youefkh05/ArduScope/README.md

# ArduScope
The purpose of this project is to address the empowerment of young people from lower-income backgrounds by providing them with affordable electronics kits that inspire future Electrical Engineers and pave the way for their success.
