youefkh05/ArduScope/Video/عربي.docx

أول حاجة مقدمة كله هيعملها

I'm (your name)

and We're Arduscope Team!

Khaled: @Khaled Sarhan duino

شرح فكرة المشروع وانا هحط في الخلفية كل جهاز وهو بيشتغل وقول كل جهاز براحة يعني قول فولت بعدها اسكت ثانية والجهاز اللي بعده

Voltmeter... and Ammetre... and Ohmeter.... with Signal generator.... and Oscilloscope

أنا هتكلم عن الهارد وير

Ameer @Ameer Louly duino :

The programming process

هتقوله ازاي عملت ال list باللوجو علي ال oled (طريقة ال pixel art اللي عملتها ده)

وبعدها أنا هقوله المشكلة اللي قابلتنا كانت الميموري وحلتها عن طريق ال EEROM

What we learn:

أنا ال EEROM

@Khaled Sarhan duino

خالد IC Design

@Ameer Louly duino

ال oled logos

Khaled @Khaled Sarhan duino :

هيخش تاني للختام

Future Work:

add more ranges with better accuracy

and for the oscilloscope to read higher frequencies
