youefkh05/ArduScope/Report/Bill/Nikhel.pdf

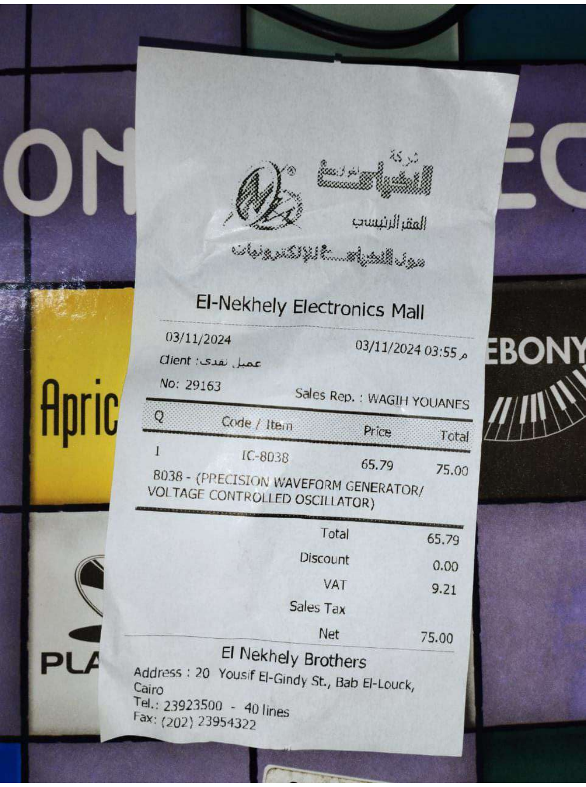
[picture p15: page 1]
