youefkh05/ArduScope/Report/Bill/RAM.pdf

CamScanner (https://v3.camscanner.com/user/download)

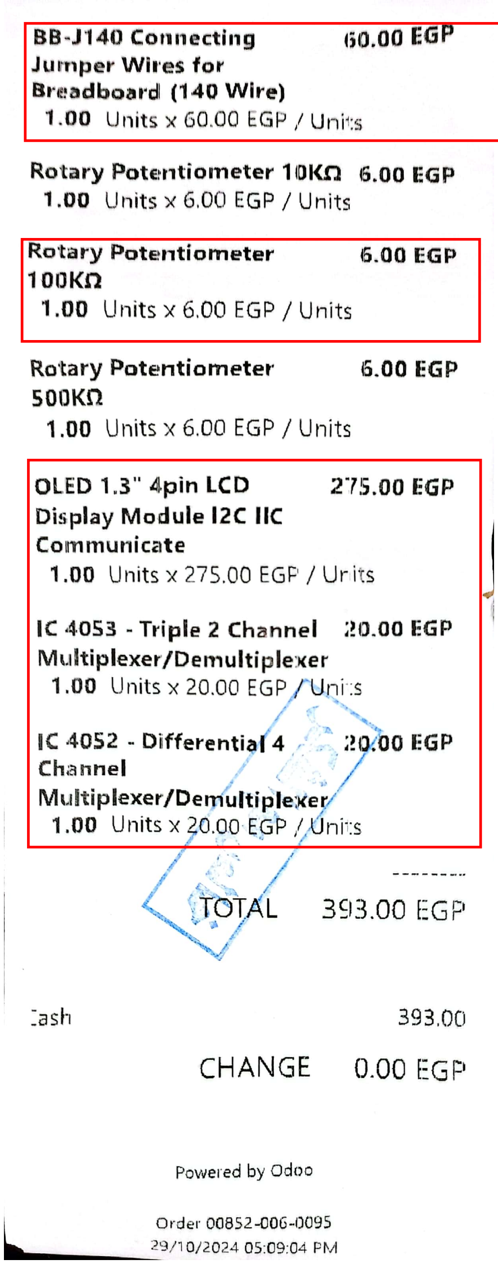
[picture p16: figure]
