youefkh05/ArduScope/Report/IEEEDuino 2024 Expenses Report.xlsx

Team Name | Yousef Khaled Omar Mahmoud
IEEE Section | Egypt
Currency used in the Expense Report | LE (Egypt) to USD
conversion rate | 50 LE/$
Expenses list
Item | Amount (LE) | Amount (USA) | Description and Comments
Arduino Nano | 275 | 5.5 | Arduino Nano 328 With CH340 Chip - Clone
USB Cable | 85 | 1.7 | USB Micro Cable Shielded 1.4m
Breadboard | 180 | 3.6 | BB-01 Breadboard 830 Tie Point
Push Button | 7 | 0.14 | The bigger size 6x6x9 mm
OLED | 275 | 5.5 | OLED 1.3" 4pin LCD Display Module I2C IIC Communicate
LM741 | 64 | 1.28 | UA741CP - Original
IC 4052 | 20 | 0.4 | IC 4052 - Differential 4 Channel Multiplexer/Demultiplexer
IC 4053 | 20 | 0.4 | IC 4053 - Triple 2 Channel Multiplexer/Demultiplexer
Pot 100k | 6 | 0.12 | 100k Ohm Potintiometre
Resistors | 5 | 0.1 | Ohm Resistor
Capacitor | 4.5 | 0.09 | Farad Capacitor
1N4148 | 1.5 | 0.03 | Small Signal Fast Switching Diodes
1N4007 | 2.5 | 0.05 | 1N4007 General Purpose Silicon Diode 1A - 1000V
TOTAL | 945.5 | 18.91
