youefkh05/ArduScope/Report/ArduScope Component.xlsx

Sheet: Sheet1
Comp Name | Description | Price in L.E | $ | Num | Total | Total $
Arduino Nano | Arduino Nano 328 With CH340 Chip - Clone | 275 | 5.5 | 1 | 275 | 5.5 | Total in L.E | Total in $
USB Cable | USB Micro Cable Shielded 1.4m | 85 | 1.7 | 1 | 85 | 1.7 | 945.5 | 18.91
Breadboard | BB-01 Breadboard 830 Tie Point | 60 | 1.2 | 3 | 180 | 3.6
Push Button | The bigger size 6x6x9 mm | 1 | 0.02 | 7 | 7 | 0.14
OLED | OLED 1.3" 4pin LCD Display Module I2C IIC Communicate | 275 | 5.5 | 1 | 275 | 5.5
LM741 | UA741CP - Original | 8 | 0.16 | 8 | 64 | 1.28
IC 4052 | IC 4052 - Differential 4 Channel Multiplexer/Demultiplexer | 20 | 0.4 | 1 | 20 | 0.4
IC 4053 | IC 4053 - Triple 2 Channel Multiplexer/Demultiplexer | 20 | 0.4 | 1 | 20 | 0.4
Pot 100k | 100k Ohm Potintiometre | 6 | 0.12 | 1 | 6 | 0.12
Resistors | Ohm Resistor | 0.2 | 0.004 | 25 | 5 | 0.1
Capacitor | Farad Capacitor | 1.5 | 0.03 | 3 | 4.5 | 0.09
1N4148 | Small Signal Fast Switching Diodes | 1.5 | 0.03 | 1 | 1.5 | 0.03
1N4007 | 1N4007 General Purpose Silicon Diode 1A - 1000V | 0.5 | 0.01 | 5 | 2.5 | 0.05

Sheet: Resistor
R | 1 | 2 | 3 | Tolerance | Shape
10
1k
1
100
12
100k
22
2.2k
1.5
12k
10
20k
15k
10k
220k
22k
2
1M
68K
24
180k
560k

Sheet: Tahrir
Comp Name | Description | Price in L.E | $ | Num | Total | Total $ | Availbale
Arduino Nano | Arduino Nano 328 With CH340 Chip - Clone | 275 | 5.5 | 1 | 275 | 5.5 | NO | Total in L.E | Total in $
USB Cable | USB Micro Cable Shielded 1.4m | 85 | 1.7 | 1 | 85 | 1.7 | NO | 1138 | 22.76
Breadboard | BB-01 Breadboard 830 Tie Point | 40 | 0.8 | 3 | 120 | 2.4 | NO
Adapter 5Vdc | Wall Power Adapter 5Vdc 2A - Dual Size Jack Output | 75 | 1.5 | 1 | 75 | 1.5 | NO
Male-Male | PH61 - 20cm Male to Male 40 Jumper Wires Set | 35 | 0.7 | 1 | 35 | 0.7 | NO
Male-Female | PH60 - 20cm Male to Female 40 Jumper Wires Set | 35 | 0.7 | 1 | 35 | 0.7 | NO
Push Button | The bigger size 6x6x9 mm | 1 | 0.02 | 8 | 8 | 0.16 | NO
OLED | OLED 1.3" 4pin LCD Display Module I2C IIC Communicate | 275 | 5.5 | 1 | 275 | 5.5 | NO
LM741 | UA741CP - Original | 10 | 0.2 | 8 | 80 | 1.6 | NO
IC 4052 | IC 4052 - Differential 4 Channel Multiplexer/Demultiplexer | 20 | 0.4 | 1 | 20 | 0.4 | NO
IC 4053 | IC 4053 - Triple 2 Channel Multiplexer/Demultiplexer | 20 | 0.4 | 1 | 20 | 0.4 | NO
ICL7660 | CMOS Voltage Converter | 20 | 0.4 | 1 | 20 | 0.4 | NO
Crocodile Clip | Crocodile Clip for 4mm Plug | 10 | 0.2 | 4 | 40 | 0.8 | NO
Slider Switch | Slide Switch 3-Pin that's big size | 5 | 0.1 | 2 | 10 | 0.2 | NO
Pot 500k | 500k Ohm Potintiometre | 1 | 0.02 | 2 | 2 | 0.04 | NO
Pot 100k | 100k Ohm Potintiometre | 1 | 0.02 | 2 | 2 | 0.04 | NO
Pot 10k | 10k Ohm Potintiometre | 1 | 0.02 | 2 | 2 | 0.04 | NO
R100k | 100k Ohm Resistor | 0.25 | 0.005 | 6 | 1.5 | 0.03 | NO
R5.1k | 5.1k Ohm Resistor | 0.25 | 0.005 | 2 | 0.5 | 0.01 | NO
R1k | 1k Ohm Resistor | 0.25 | 0.005 | 8 | 2 | 0.04 | NO
R2 | 2 Ohm Resistor | 0.25 | 0.005 | 2 | 0.5 | 0.01 | NO
R180k | 180k Ohm Resistor | 0.25 | 0.005 | 2 | 0.5 | 0.01 | NO
R12k | 12k Ohm Resistor | 0.25 | 0.005 | 2 | 0.5 | 0.01 | NO
R10k | 10k Ohm Resistor | 0.25 | 0.005 | 8 | 2 | 0.04 | NO
R200k | 200k Ohm Resistor | 0.25 | 0.005 | 2 | 0.5 | 0.01 | NO
R500k | 500k Ohm Resistor | 0.25 | 0.005 | 2 | 0.5 | 0.01 | NO
R390k | 390k Ohm Resistor | 0.25 | 0.005 | 2 | 0.5 | 0.01 | NO
R20k | 20k Ohm Resistor | 0.25 | 0.005 | 2 | 0.5 | 0.01 | NO
R3k | 3k Ohm Resistor | 0.25 | 0.005 | 2 | 0.5 | 0.01 | NO
R100 | 100 Ohm Resistor | 0.25 | 0.005 | 2 | 0.5 | 0.01 | NO
R1M | 1M Ohm Resistor | 0.25 | 0.005 | 2 | 0.5 | 0.01 | NO
C1n | 1n Farad Capacitor | 0.25 | 0.005 | 2 | 0.5 | 0.01 | NO
C100n | 100n Farad Capacitor | 0.25 | 0.005 | 4 | 1 | 0.02 | NO
C10u | 10u Farad Capacitor | 0.25 | 0.005 | 4 | 1 | 0.02 | NO
C100u | 100u Farad Capacitor | 0.25 | 0.005 | 2 | 0.5 | 0.01 | NO
1N4148 | Small Signal Fast Switching Diodes | 1 | 0.02 | 2 | 2 | 0.04 | NO
1N4732A | 1N4732 4.7V 1W Zener Diode | 7 | 0.14 | 2 | 14 | 0.28 | NO
1N4007 | 1N4007 General Purpose Silicon Diode 1A - 1000V | 0.5 | 0.01 | 8 | 4 | 0.08 | NO
 |  |  | 0 |  | 0 | 0 | NO
 |  |  | 0 |  | 0 | 0 | NO
 |  |  | 0 |  | 0 | 0 | NO
 |  |  | 0 |  | 0 | 0 | NO
 |  |  |  |  | 0 | 0 | NO
 |  |  |  |  | 0 | 0 | NO
 |  |  |  |  | 0 | 0 | NO
 |  |  |  |  | 0 |  | NO
 |  |  |  |  |  |  | NO
 |  |  |  |  |  |  | NO
 |  |  |  |  |  |  | NO
 |  |  |  |  |  |  | NO
 |  |  |  |  |  |  | NO
 |  |  |  |  |  |  | NO
 |  |  |  |  |  |  | NO
 |  |  |  |  |  |  | NO
 |  |  |  |  |  |  | NO
 |  |  |  |  |  |  | NO
 |  |  |  |  |  |  | NO
 |  |  |  |  |  |  | NO
 |  |  |  |  |  |  | NO
 |  |  |  |  |  |  | NO
 |  |  |  |  |  |  | NO
 |  |  |  |  |  |  | NO
 |  |  |  |  |  |  | NO
 |  |  |  |  |  |  | NO
 |  |  |  |  |  |  | NO
 |  |  |  |  |  |  | NO
 |  |  |  |  |  |  | NO
 |  |  |  |  |  |  | NO
 |  |  |  |  |  |  | NO
 |  |  |  |  |  |  | NO
 |  |  |  |  |  |  | NO
 |  |  |  |  |  |  | NO
 |  |  |  |  |  |  | NO
 |  |  |  |  |  |  | NO
 |  |  |  |  |  |  | NO
 |  |  |  |  |  |  | NO
 |  |  |  |  |  |  | NO
 |  |  |  |  |  |  | NO
 |  |  |  |  |  |  | NO
 |  |  |  |  |  |  | NO
 |  |  |  |  |  |  | NO
 |  |  |  |  |  |  | NO
 |  |  |  |  |  |  | NO
 |  |  |  |  |  |  | NO
 |  |  |  |  |  |  | NO
 |  |  |  |  |  |  | NO
 |  |  |  |  |  |  | NO
 |  |  |  |  |  |  | NO
 |  |  |  |  |  |  | NO
 |  |  |  |  |  |  | NO
 |  |  |  |  |  |  | NO
 |  |  |  |  |  |  | NO
 |  |  |  |  |  |  | NO
 |  |  |  |  |  |  | NO
 |  |  |  |  |  |  | NO
 |  |  |  |  |  |  | NO
 |  |  |  |  |  |  | NO
 |  |  |  |  |  |  | NO
 |  |  |  |  |  |  | NO
 |  |  |  |  |  |  | NO
 |  |  |  |  |  |  | NO
 |  |  |  |  |  |  | NO
 |  |  |  |  |  |  | NO
 |  |  |  |  |  |  | NO
 |  |  |  |  |  |  | NO
 |  |  |  |  |  |  | NO
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
 |  |  |  |  |  |  | NO
 |  |  |  |  |  |  | NO
 |  |  |  |  |  |  | NO
 |  |  |  |  |  |  | NO
 |  |  |  |  |  |  | NO
 |  |  |  |  |  |  | NO
 |  |  |  |  |  |  | NO
 |  |  |  |  |  |  | NO
 |  |  |  |  |  |  | NO
 |  |  |  |  |  |  | NO
 |  |  |  |  |  |  | NO
 |  |  |  |  |  |  | NO
