youefkh05/ArduScope/Simulation/Signal Gen/FUNCTION GENERATOR ICL8038/DSO OP.pdf

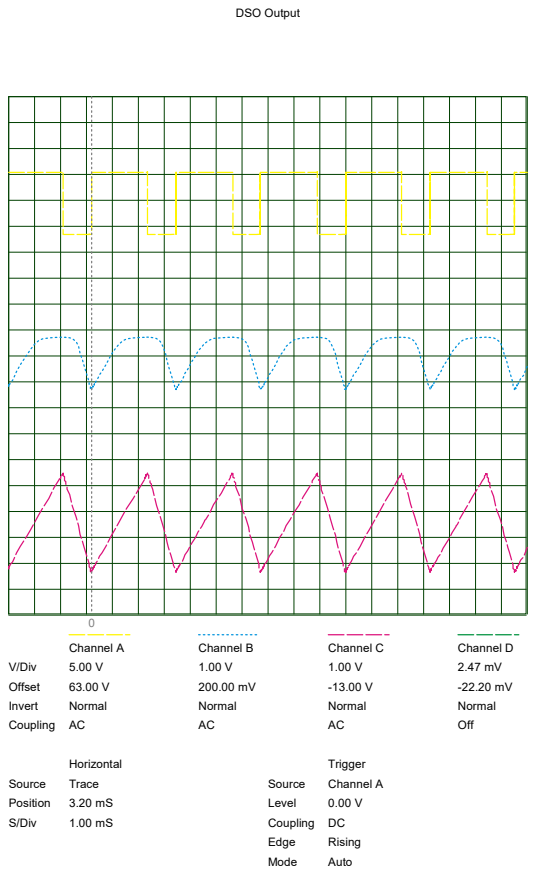
[picture p17: page 1]
DSO Output; V/Div Offset Invert Coupling; Channel A 5.00 V 63.00 V Normal AC; Channel B 1.00 V 200.00 mV Normal AC; Channel C 1.00 V -13.00 V Normal AC; Channel D 2.47 mV -22.20 mV Normal Off; Horizontal; Source Position S/Div; Trace 3.20 mS 1.00 mS; Trigger; Source Level Coupling Edge Mode; Channel A 0.00 V DC Rising Auto
