youefkh05/ArduScope/(list of files, drawings)

Other design files:
Simulation/Ameter_test.pdsprj
Simulation/Analog_Mux_Test.pdsprj
Simulation/App Test.pdsprj
Simulation/Ardu Ocsi MM.pdsprj
Simulation/Ocsilloscpe Test.pdsprj
Simulation/OHM_test .pdsprj
Simulation/Project Backups/Ameter_test [20241016, 21-12-04].pdsprj
Simulation/Project Backups/Ameter_test [20241016, 22-32-01].pdsprj
Simulation/Project Backups/Ameter_test [20241022, 14-19-21].pdsprj
Simulation/Project Backups/Ameter_test [20241022, 14-43-55].pdsprj
Simulation/Project Backups/Ameter_test [20241028, 09-45-11].pdsprj
Simulation/Project Backups/Analog_Mux_Test [20241016, 12-39-41].pdsprj
Simulation/Project Backups/App Test [20241028, 10-33-46].pdsprj
Simulation/Project Backups/App Test [20241102, 14-48-27].pdsprj
Simulation/Project Backups/App Test [20241103, 12-03-20].pdsprj
Simulation/Project Backups/App Test [20241104, 09-50-23].pdsprj
Simulation/Project Backups/App Test [20241104, 09-53-16].pdsprj
Simulation/Project Backups/App Test [20241108, 10-38-39].pdsprj
Simulation/Project Backups/Ardu Ocsi MM - Copy [20241015, 12-36-51].pdsprj
Simulation/Project Backups/Ardu Ocsi MM - Copy [20241015, 14-16-43].pdsprj
Simulation/Project Backups/Ardu Ocsi MM [20241022, 14-19-22].pdsprj
Simulation/Project Backups/Ardu Ocsi MM [20241022, 14-43-53].pdsprj
Simulation/Project Backups/Ardu Ocsi MM [20241022, 14-46-21].pdsprj
Simulation/Project Backups/Ardu Ocsi MM [20241022, 21-13-32].pdsprj
Simulation/Project Backups/Ardu Ocsi MM [20241023, 12-56-41].pdsprj
Simulation/Project Backups/Ardu Ocsi MM [20241023, 13-01-33].pdsprj
Simulation/Project Backups/Ardu Ocsi MM [20241023, 13-05-48].pdsprj
Simulation/Project Backups/Ardu Ocsi MM [20241030, 12-55-29].pdsprj
Simulation/Project Backups/Ardu Ocsi MM [20241030, 17-13-44].pdsprj
Simulation/Project Backups/Ardu Ocsi MM [20241109, 20-14-22].pdsprj
Simulation/Project Backups/MM_Test [20241015, 19-44-46].pdsprj
Simulation/Project Backups/Ocsilloscpe Test [20241026, 14-43-50].pdsprj
Simulation/Project Backups/Ocsilloscpe Test [20241026, 14-43-51].pdsprj
Simulation/Project Backups/Ocsilloscpe Test [20241026, 23-51-34].pdsprj
Simulation/Project Backups/Ocsilloscpe Test [20241027, 22-46-38].pdsprj
Simulation/Project Backups/Ocsilloscpe Test [20241028, 10-12-29].pdsprj
Simulation/Project Backups/Ocsilloscpe Test [20241105, 21-48-28].pdsprj
Simulation/Project Backups/Ocsilloscpe Test [20241106, 21-08-37].pdsprj
Simulation/Project Backups/Ocsilloscpe Test [20241106, 21-50-35].pdsprj
Simulation/Project Backups/Ocsilloscpe Test [20241107, 15-33-00].pdsprj
Simulation/Project Backups/Ocsilloscpe Test [20241108, 10-38-46].pdsprj
Simulation/Project Backups/OHM_test [20241022, 14-46-15].pdsprj
Simulation/Project Backups/OHM_test [20241030, 11-41-39].pdsprj
Simulation/Project Backups/Signal_Gen_Test [20241109, 16-52-29].pdsprj
Simulation/Project Backups/VOLT_test [20241022, 14-10-31].pdsprj
Simulation/Project Backups/VOLT_test [20241022, 14-17-11].pdsprj
Simulation/Project Backups/VOLT_test [20241022, 14-43-56].pdsprj
Simulation/Project Backups/VOLT_test [20241028, 09-45-13].pdsprj
Simulation/Project Backups/VOLT_test [20241030, 12-55-27].pdsprj
Simulation/Project Backups/VOLT_test [20241030, 13-59-22].pdsprj
Simulation/Project Backups/VOLT_test [20241030, 14-01-12].pdsprj
Simulation/Project Backups/VOLT_test [20241030, 15-58-10].pdsprj
Simulation/Signal Gen/FUNCTION GENERATOR ICL8038/Project Backups/function generoter icl8038 WORKING [20241106, 22-13-27].pdsprj
Simulation/Signal Gen/FUNCTION GENERATOR ICL8038/Project Backups/function generoter icl8038 WORKING [20241107, 15-33-04].pdsprj
Simulation/Signal Gen/Signal_Gen.ms14
Simulation/Signal_Gen_test.pdsprj
Simulation/VOLT_test.pdsprj
