youefkh05/ArduScope/(commit log)

2024-10-11 Added the simulation
    It contains:
    1.Arduino Block
    2.Power Block
    3.Ohmetre Block
    4.Voltmetre Block
    5.Ametre Block
    6.Dc Bias Block
    7.Dc out Block
    8.Ac Bias Block
    9.Selector Block
    10.Signal Generator Block
    [Ardu Ocsi MM [20240501, 12-41-49].pdsprj, Ardu Ocsi MM [20240519, 02-29-17].pdsprj, Ardu Ocsi MM [20240519, 02-43-08].pdsprj, Ardu Ocsi MM.pdsprj]
2024-10-11 Organized the res
    Made a Report and Simulation folder
    [Ardu Ocsi MM [20240501, 12-41-49].pdsprj, Ardu Ocsi MM [20240519, 02-29-17].pdsprj, Ardu Ocsi MM [20240519, 02-43-08].pdsprj, Ardu Ocsi MM.pdsprj]
2024-10-11 Added the Arduino library
    It has the arduino boatloader
    [Ardu Ocsi MM [20241011, 20-53-42].pdsprj, Ardu Ocsi MM [20241011, 21-50-26].pdsprj, Ardu Ocsi MM.pdsprj, MM Full [20240418, 10-46-46].pdsprj, MM Full [20240418, 11-04-10].pdsprj, MM Full [20240418, 11-49-43].pdsprj, MM Full.pdsprj]
2024-10-13 Added FreeRTOS
    Added the FreeRTOS library for Arduino
    Arduino_FreeRTOS.h
    [Ardu Ocsi MM [20241011, 22-08-27].pdsprj, Ardu Ocsi MM [20241013, 07-18-47].pdsprj, Ardu Ocsi MM.pdsprj]
2024-10-13 Added OLED
    its 128*64 I2C OLED
    [Ardu Ocsi MM [20241013, 11-17-06].pdsprj, Ardu Ocsi MM.pdsprj]
2024-10-13 Made the simulation layout
    It's more Organized and contains these blocks:
    1.GND
    2.NEGATIVE_REGULATOR1
    3.POSITIVE_REGULATOR1
    4.MC_VCC
    5.DC_POWER
    6.AC_OUT
    7.+2.5V_DC_BIAS
    8.Voltage Circuit
    9.Ammeter
    10.ohmetre
    11.Selector Block
    12.Signal generator
    13.Arduino Block
    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
    [Ardu Ocsi MM [20241013, 12-28-38].pdsprj, Ardu Ocsi MM [20241013, 12-41-34].pdsprj, Ardu Ocsi MM.pdsprj]
2024-10-14 Made DC only block
    It's much smaller than before
    [Ardu Ocsi MM [20240501, 12-41-49].pdsprj, Ardu Ocsi MM [20240519, 02-29-17].pdsprj, Ardu Ocsi MM [20241014, 17-16-18].pdsprj, Ardu Ocsi MM [20241014, 17-16-36].pdsprj, Ardu Ocsi MM.pdsprj]
2024-10-15 Added the Multi_Metre header
    Function Prototypes:
    Read_Volt
    Read_Amp
    Display_Ohm
    Select_Mux
    Ask_To_Return
    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
    [Ardu Ocsi MM - Copy [20241015, 12-36-51].pdsprj, Ardu Ocsi MM - Copy [20241015, 14-16-43].pdsprj, Ardu Ocsi MM - Copy.pdsprj, Ardu Ocsi MM [20240519, 02-43-08].pdsprj, Ardu Ocsi MM [20241011, 20-53-42].pdsprj, Ardu Ocsi MM [20241015, 12-33-21].pdsprj, Ardu Ocsi MM [20241015, 14-16-40].pdsprj, Ardu Ocsi MM.pdsprj]
2024-10-16 Added Read_Volt Function
    It converts the analog input into a volt value whether it's AC or DC
    [Ardu Ocsi MM [20241011, 21-50-26].pdsprj, Ardu Ocsi MM [20241015, 19-44-53].pdsprj, Ardu Ocsi MM.pdsprj, MM_Test [20241015, 19-44-46].pdsprj, MM_Test.pdsprj, VOLT ac_test.pdsprj]
2024-10-16 Added Read_Ohm Function
    It reads the Rin and converts it to Resistor value in Ohm
2024-10-16 Added the Select_Mux function
    It's used to select the devices with its ranges using the analog Mux
    [Ardu Ocsi MM [20241011, 22-08-27].pdsprj, Ardu Ocsi MM [20241016, 10-31-20].pdsprj, Ardu Ocsi MM.pdsprj]
2024-10-16 Edited the voltametre device
    It works better now
    [Analog_Mux_Test [20241016, 12-39-41].pdsprj, Analog_Mux_Test.pdsprj, Ardu Ocsi MM [20241013, 07-18-47].pdsprj, Ardu Ocsi MM [20241016, 15-17-09].pdsprj, Ardu Ocsi MM.pdsprj, VOLT ac_test [20241016, 15-17-08].pdsprj, VOLT ac_test.pdsprj]
2024-10-16 Finished the voltameter device
    It works properly
    [Ardu Ocsi MM [20241013, 11-17-06].pdsprj, Ardu Ocsi MM [20241013, 12-28-38].pdsprj, Ardu Ocsi MM [20241016, 17-54-56].pdsprj, Ardu Ocsi MM [20241016, 19-24-00].pdsprj, Ardu Ocsi MM.pdsprj, VOLT ac_test [20241016, 17-54-54].pdsprj, VOLT ac_test [20241016, 19-24-01].pdsprj, VOLT ac_test.pdsprj]
2024-10-16 Finished Ameter Device
    It works propely now
    [Ameter_test [20241016, 19-39-09].pdsprj, Ameter_test [20241016, 21-12-04].pdsprj, Ameter_test [20241016, 22-32-01].pdsprj, Ameter_test.pdsprj, Ardu Ocsi MM [20241013, 12-41-34].pdsprj, Ardu Ocsi MM [20241014, 17-16-18].pdsprj, Ardu Ocsi MM [20241014, 17-16-36].pdsprj, Ardu Ocsi MM [20241016, 20-52-56].pdsprj]
2024-10-16 Finished The MM
    It contains: Ammeter, Voltmeter, Ohmeter
    [Ardu Ocsi MM [20241015, 12-33-21].pdsprj, Ardu Ocsi MM [20241016, 23-35-11].pdsprj, Ardu Ocsi MM.pdsprj, OHM_test [20241016, 23-18-55].pdsprj, OHM_test .pdsprj]
2024-10-16 Finished the MM
    It works properly in real time
    [Ardu Ocsi MM [20241015, 14-16-40].pdsprj, Ardu Ocsi MM [20241015, 19-44-53].pdsprj, Ardu Ocsi MM [20241016, 23-46-57].pdsprj, Ardu Ocsi MM [20241017, 00-27-37].pdsprj, Ardu Ocsi MM.pdsprj, MM_Test.pdsprj, Signal_Gen [20241017, 00-29-08].pdsprj, Signal_Gen.pdsprj]
2024-10-22 Added Multi_Metre Enumes
    added devices, ranges and modes enums
2024-10-22 Modified the volt circuit simulation
    It now operators with 5,3.3 volt (using the arduino nano power)
    [Ameter_test [20241022, 14-19-21].pdsprj, Ameter_test.pdsprj, Ardu Ocsi MM [20241016, 10-31-20].pdsprj, Ardu Ocsi MM [20241022, 14-19-22].pdsprj, Ardu Ocsi MM.pdsprj, MM Full [20240418, 10-46-46].pdsprj, MM Full [20240418, 11-04-10].pdsprj, MM Full [20240418, 11-49-43].pdsprj]
2024-10-22 Modified the MM_Circuit
    Now it operates at 5, 3.3 Volt
    [Ameter_test [20241022, 14-43-55].pdsprj, Ameter_test.pdsprj, Ardu Ocsi MM [20241016, 15-17-09].pdsprj, Ardu Ocsi MM [20241016, 17-54-56].pdsprj, Ardu Ocsi MM [20241022, 14-43-53].pdsprj, Ardu Ocsi MM [20241022, 14-46-21].pdsprj, Ardu Ocsi MM.pdsprj, OHM_test [20241022, 14-46-15].pdsprj]
2024-10-22 Added the Signal Generator Circuit
    It contains Sin, Tri and square waves with 5-50k Hz
    [Ardu Ocsi MM [20241016, 19-24-00].pdsprj, Ardu Ocsi MM [20241022, 21-13-32].pdsprj, Ardu Ocsi MM.pdsprj, Signal_Gen [20241022, 21-13-40].pdsprj, Signal_Gen [20241022, 21-32-47].pdsprj, Signal_Gen.ms14, Signal_Gen.pdsprj, Signal_Gen_test - Copy [20241022, 19-22-46].pdsprj]
2024-10-23 Added the sig header file
    It's now MM_Sig that controlls the MM and sig devices
    [Signal_Gen [20241023, 11-00-20].pdsprj, Signal_Gen [20241023, 11-27-01].pdsprj, Signal_Gen.ms14, Signal_Gen.pdsprj]
2024-10-23 Signal generator header file finished
    It contains : Square, Triangular and sin waves
    [Ardu Ocsi MM [20241016, 20-52-56].pdsprj, Ardu Ocsi MM [20241016, 20-53-28].pdsprj, Ardu Ocsi MM [20241016, 22-32-05].pdsprj, Ardu Ocsi MM [20241023, 12-56-41].pdsprj, Ardu Ocsi MM [20241023, 13-01-33].pdsprj, Ardu Ocsi MM [20241023, 13-05-48].pdsprj, Ardu Ocsi MM.pdsprj]
2024-10-26 Added the osciloscope circuit
    It has 3 options
    [Ocsilloscpe Test [20241026, 14-02-53].pdsprj, Ocsilloscpe Test.pdsprj, Signal_Gen.ms14]
2024-10-26 Made Oscilliscope Circuit better
    It now more integrated with Nano
    [Ocsilloscpe Test [20241026, 14-43-50].pdsprj, Ocsilloscpe Test [20241026, 14-43-51].pdsprj, Ocsilloscpe Test.pdsprj]
2024-10-26 Finished Osci driver
    It contains Osci_Init and Osci_Run
2024-10-26 Added exit interrupt
    Now you can exit from the osciscope
2024-10-27 Interrupt Exit works!
    debugged the Interupt mechanism in Osci_Run and it works properly
    [Ocsilloscpe Test [20241026, 23-51-34].pdsprj, Ocsilloscpe Test.pdsprj]
2024-10-27 ADA fruit instead of u8g
    We'll convert the main library from u8g to ada fruit as the u8g doesn't have i2csetadress
    [Ocsilloscpe Test [20241027, 22-46-38].pdsprj, Ocsilloscpe Test.pdsprj]
2024-10-28 Added App simulation
    It has a menu item display using 3 buttons: next, select, prev
    [Ameter_test [20241028, 09-45-11].pdsprj, Ameter_test.pdsprj, App Test [20241028, 10-16-57].pdsprj, App Test.pdsprj, Ocsilloscpe Test [20241028, 10-12-29].pdsprj, VOLT_test [20241028, 09-45-13].pdsprj, VOLT_test.pdsprj]
2024-10-28 Added the integration in the simulation
    now the pins are correctly connected
    [App Test [20241028, 10-33-46].pdsprj, App Test.pdsprj]
2024-10-30 Removed the bypass capacitor from the voltage circuit
    It works properly without them
    [OHM_test [20241030, 11-41-39].pdsprj, OHM_test .pdsprj]
2024-10-30 Finshed the final circuit design
    [Ardu Ocsi MM [20241016, 23-35-11].pdsprj, Ardu Ocsi MM [20241016, 23-46-57].pdsprj, Ardu Ocsi MM [20241030, 12-55-29].pdsprj, Ardu Ocsi MM [20241030, 17-13-44].pdsprj, Ardu Ocsi MM.pdsprj, VOLT_test [20241030, 12-55-27].pdsprj, VOLT_test [20241030, 13-59-22].pdsprj, VOLT_test [20241030, 14-01-12].pdsprj]
2024-11-02 Added the oscilliscope code
    It works fine but need ti be integrated with the main code for memory
    [App Test [20241102, 14-48-27].pdsprj, App Test.pdsprj]
2024-11-03 Added EEROM
    It saves the bitmaps in order to save the memory
    [App Test [20241103, 12-03-20].pdsprj, App Test.pdsprj]
2024-11-04 Removed the u8g lib
    We replaced it with ada fruit linrary for integration
    [Osci.h, bitmaps.h, eerom.ino, eerom_map.h, menu_code.ino]
2024-11-04 simulation now works
    you can debug using app test
    [App Test [20241104, 09-50-23].pdsprj, App Test [20241104, 09-53-16].pdsprj, App Test.pdsprj]
2024-11-05 Edited the osciliscope simulation
    It works properly now
    [Ocsilloscpe Test [20241105, 21-48-28].pdsprj, Ocsilloscpe Test.pdsprj]
2024-11-06 Added Editable size Osci
    Its size now can be edited
    [Ocsilloscpe Test [20241106, 21-08-37].pdsprj, Ocsilloscpe Test.pdsprj]
2024-11-06 Added sig gen circuit
    It uses ICL 8038 as a function generator
    [Ocsilloscpe Test [20241106, 21-50-35].pdsprj, Ocsilloscpe Test.pdsprj, function generoter icl8038 WORKING [20241106, 22-13-27].pdsprj, function generoter icl8038 WORKING .pdsprj]
2024-11-09 Added the semi-final circuit
    We're getting close!
    [App Test [20241108, 10-38-39].pdsprj, App Test.pdsprj, Ardu Ocsi MM [20241017, 00-27-37].pdsprj, Ardu Ocsi MM [20241109, 20-14-22].pdsprj, Ardu Ocsi MM.pdsprj, Ocsilloscpe Test [20241026, 14-02-53].pdsprj, Ocsilloscpe Test [20241107, 15-33-00].pdsprj, Ocsilloscpe Test [20241108, 10-38-46].pdsprj]
2024-11-11 Added Application cpp
    It contains the functions:
    void getSignalMenuItem(uint8_t index, char *buffer, size_t bufferSize);
    void getMenuItem(uint8_t index, char *buffer, size_t bufferSize);
    void drawMenuItem(int y_position, uint8_t index, uint8_t type);
    void configMenu(void);
    [Signal_Gen.ms14]
2024-11-17 Video Material
    It needs editing and montage
2024-11-19 Added the report
    we made the components and code.pdf
    [ArduScope Component.xlsx]
2024-11-22 Added the Bills
    It contains the components bills that we used
    [ArduScope Component.xlsx, IEEEDuino 2024 Expenses Report.xlsx]
